Yarad/mx-anywhere-3-case/mice/mx-anywhere-3/3d/case_closed.stl

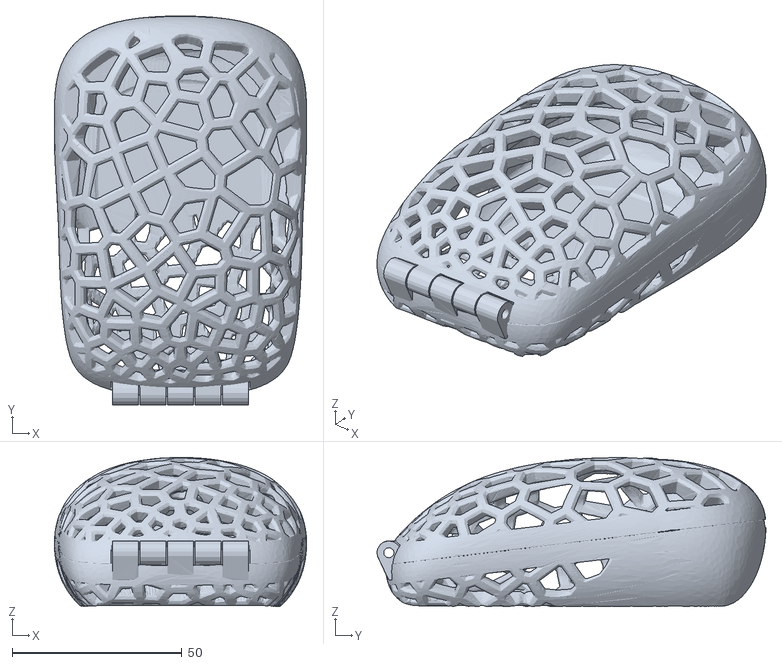
[picture p4: CAD file, 2026-11-08]
mice/mx-anywhere-3/3d/case_closed.stl
74.2 x 114.5 x 43.9
