Yarad/mx-anywhere-3-case/mice/mx-anywhere-3/3d/case_open.stl

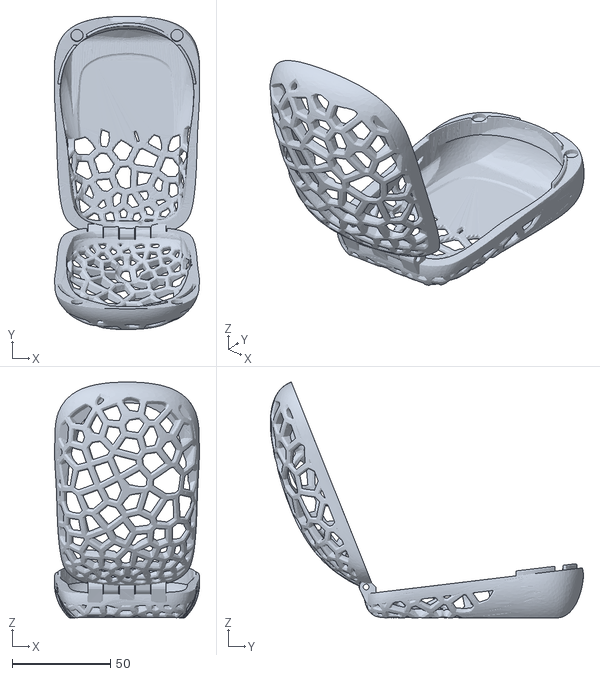
[picture p5: CAD file, 2026-11-08]
mice/mx-anywhere-3/3d/case_open.stl
74.2 x 159.8 x 120.4
