Yarad/mx-anywhere-3-case/PRINTING.ru.md

# Чехол MX Anywhere 3 — печать и сборка

[English](PRINTING.md) · **Русский**

## Файлы для печати

Готовые файлы приложены к [последнему релизу](https://github.com/Yarad/mx-anywhere-3-case/releases/latest). Чтобы собрать их самому, выполните `.venv/bin/python -m case mx-anywhere-3 build print` — они появятся в `build/mx-anywhere-3/print/` (для другой мыши — имя её папки в `mice/`):

| Файл | Что это |
| --- | --- |
| `mx_case_plate.3mf` | обе детали на одном столе, уже в положении для печати |
| `mx_case_base.stl` | основание, в положении для печати |
| `mx_case_lid.stl` | крышка, в положении для печати |

Карта демпферов — `.venv/bin/python -m case mx-anywhere-3 bumper_map`, файл `build/mx-anywhere-3/print/bumper_map.ru.png` (английская версия — `bumper_map.png`).

## Заказ

Отправлять салону печати — архив заказа из релиза (или собрать его командой `.venv/bin/python -m case mx-anywhere-3 order` в `build/mx-anywhere-3/mx-anywhere-3_case_order.zip`):

| В архиве | Что это |
| --- | --- |
| `case_base_PETG_gray.stl` | основание — **PETG серый** |
| `case_lid_PETG_white-transparent.stl` | крышка — **PETG белый прозрачный** |
| `zakaz.txt` | текст заказа: цвета, положение на столе, поддержки, настройки |
| `na_stole.png`, `cveta.png` | как детали лежат на столе и как выглядит готовый чехол |

Цвета — `[design] colors` в `case.toml` мыши (названия из `case/colors.py`), язык заказа — `[print] order_language` (`ru` или `en`). STL не хранит цвет, поэтому он в названии файла и в тексте заказа. Детали разных цветов печатаются отдельными заданиями.

## Для 3D Pixel

- **Материал:** PETG.
- **Принтер:** многоцветный 256 × 256 × 256 (Bambu); обе детали помещаются и на 220 × 220.
- **Сопло / слой:** 0.4 мм / 0.2 мм.
- **Стенки:** 3 периметра, заполнение 100 % — детали тонкие, это фактически сплошной пластик.
- **Основание:** лежит дном на столе. Поддержки **не нужны**.
- **Крышка:** лежит плоским краем (плоскостью разъёма) на столе, куполом вверх. Нужны **древовидные поддержки только от стола** (support on build plate only) — они растут внутри купола и держат рёбра сетки снизу. Снаружи крышки поддержек быть не должно.
- **Отверстия петли** имеют каплевидный верх и печатаются без поддержек.
- Ориентацию не менять: в файлах она уже правильная.

## Что купить

| Что | Сколько |
| --- | --- |
| Магниты неодимовые, диск 6 × 2 мм | 4 шт |
| Пруток / винт Ø 3 мм, длина 40 мм (винт M3 × 40, стальной пруток или спица) | 1 шт |
| Демпферы силиконовые самоклеящиеся Ø 6 × 2 мм | 12 шт |
| Демпфер Ø 4–5 × 2 мм (или кусочек того же) на носик перед колесом | 1 шт |
| Клей: цианоакрилат («супер-клей») или эпоксидка | для магнитов |

## Сборка

1. **Магниты.** В задних углах крышки и основания по гнезду Ø 6.2 мм. Сложите все 4 магнита в один столбик и пометьте маркером верхнюю сторону каждого. В основание вклейте их **помеченной стороной наружу** (к линии разъёма), в крышку — **помеченной стороной внутрь гнезда** (ко дну). Проверьте, что крышка притягивается, пока клей не схватился.
2. **Петля.** Совместите проушины крышки и основания и вставьте пруток: в проушинах основания он сидит плотно (Ø 3.0), в проушинах крышки вращается свободно (Ø 3.25). Если сел слишком туго — пройдите отверстия крышки сверлом 3.2–3.3 мм.
3. **Демпферы** — по карте ниже: 8 шт в основании, 5 шт в крышке. Каждый клеится на утолщённый узел сетки или на сплошную стенку точно под своим номером. Мышь касается чехла только через них; остальная поверхность — в 1.7 мм от мыши.

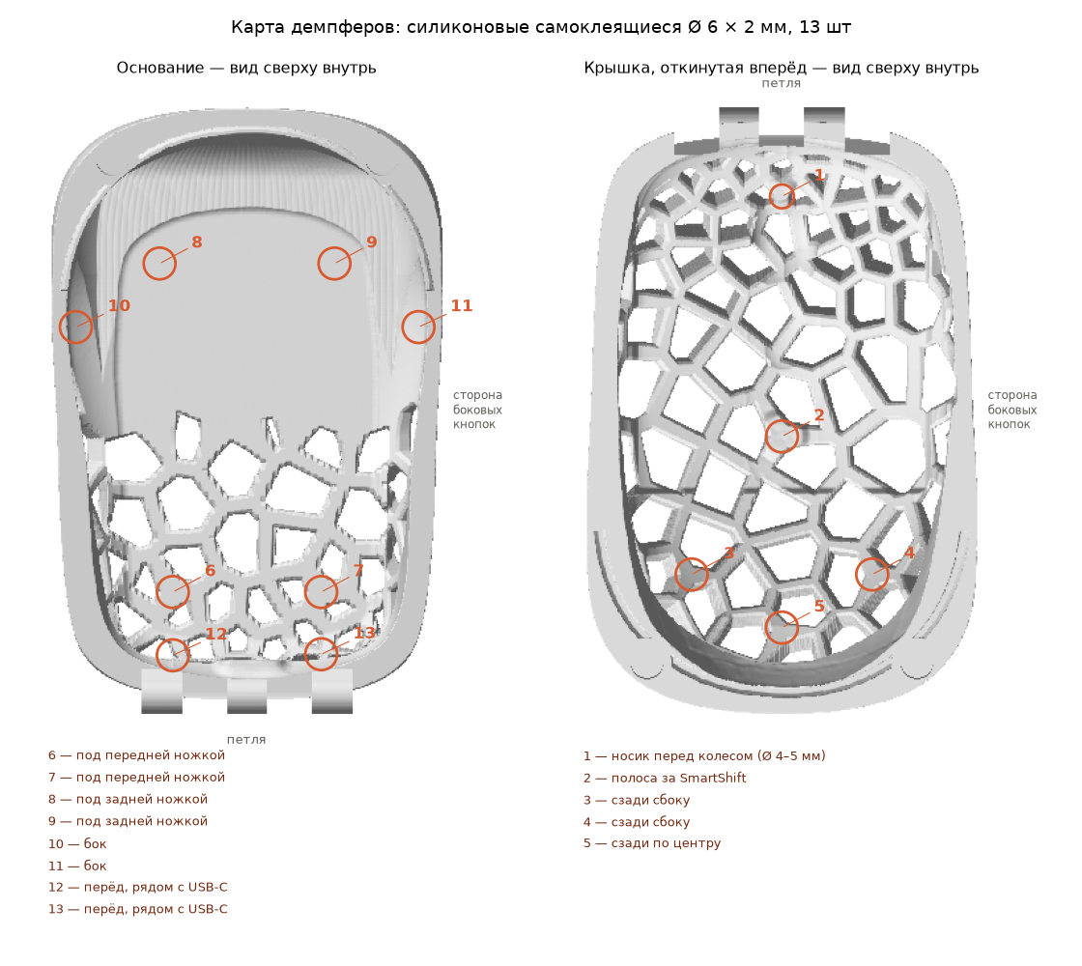
[picture p6: docs/bumper_map.ru.png]
Карта демпферов


## Параметры, если что-то не подошло

Поменяйте `case.toml` мыши (значения по умолчанию с пояснениями — в `case/defaults.toml`) и пересоберите одной командой:

- другой пруток — `[parts] rod` (отверстия крышки шире на 0.25 мм: `[tech] rod_play`);
- другие демпферы — `[parts] bumper` (зазор = высота демпфера − 0.3 мм);
- тугой или свободный бортик — `[tech] lip_clear`;
- другие магниты — `[parts] magnet`.
