Yarad/mx-anywhere-3-case/(commit log)

2026-11-01 Lattice carry case for Logitech MX Anywhere 3: first prototype
    Parametric build from the mouse scan: smooth Bezier outer form, cavity with
    gaps per zone swept along the opening motions, tilted parting plane with an
    inner lip, printed 5-knuckle hinge for a 3 mm rod, pockets for 6x2 magnets,
    contact pads, and a Voronoi lattice with wedge ribs in the "heel" layout.
    Build with: .venv/bin/python -m case.build stage2
2026-11-01 Rest the mouse on lattice nodes; shrink cells only near the hinge
    Contacts no longer get round pads: three seeds around each contact put a
    lattice node right over it, and the ribs fatten a little there to land a
    6 mm bumper. Contacts inside solid areas use the wall itself. The default
    gap is 1.7 mm so the mouse touches only the 2 mm bumpers.
    Cells shrink towards the hinge only in its last ~6 cm, and next to solid
    areas only at the very end of the transition. Solid areas are a 3 mm skin.
    Builds also write light preview GLBs that the viewer can open.
2026-11-01 Heel wraps the back of the lid; fine cells only at the hinge
    The solid heel's diagonal is steeper, so it reaches over the back edge of
    the lid: along the lid it now reads solid -> large cells -> small cells at
    the hinge. Cells no longer shrink next to solid areas; their holes close
    up instead. GLB exports are rotated to glTF's Y-up so the case lies flat
    in viewers.
2026-11-01 Print-ready build: oriented parts, plate, bumper map, checks
    `python -m case.build print` builds at 0.2 mm and writes the base (flat
    bottom on the bed) and the lid (rim on the bed, tree supports inside the
    dome only) as STL plus one 3MF plate, a bumper map and light previews.
    The approved lattice layout is pinned in case/approved_seeds.npy so it
    survives resolution and small form changes.
    Fixes found while preparing the print:
    - 45 deg print chamfer along the bottom edge of the base (was a flat
    overhang over the bed)
    - wedge ribs stop narrowing at 2 mm, inner face at least 1 mm (deep ribs
    went down to 0.3 mm)
    - lip only around the back third: along the sides the lid skirt next to
    the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
2026-11-01 Colours and the order package for the print shop
    Chosen PETG colours from 3D Pixel's palette: lid white transparent, base
    gray (PRINT_COLORS in params). `python -m case.order` zips the two STLs
    with the colour in their names, the order text, and pictures of the parts
    on the bed and of the finished case. `case.colors` renders colour schemes
    from the shop's palette for choosing.
2026-11-01 README, CC BY-NC 4.0 licence and pictures for publishing
    The mouse scan is no longer part of the repository (its licence is
    unclear); the README explains which frame a replacement scan must use.
2026-11-01 Docs in English and Russian
    English stays the main language: README.md and PRINTING.md (now
    translated), with README.ru.md and PRINTING.ru.md alongside and a language
    switch at the top of each. The case views and the bumper map are rendered
    in both languages; the order package for the print shop keeps the Russian
    pictures and order text.
2026-11-02 3D previews on GitHub and links to the release
    GitHub's own 3D viewer shows STL files up to 10 MB, so docs/3d holds the
    closed and open case as single STLs coarsened just enough to fit (0.08 mm,
    `python -m case.preview github`); no mouse in them, the scan stays private.
    The READMEs link to them and to the latest release, where the print files
    live, so the case can be printed without Python or the scan.
    Each part now keeps only its one real body: marching cubes left about 40
    sub-voxel crumbs in the base lattice that slicers would flag.
    [case_closed.stl, case_open.stl]
2026-11-02 A case for any mouse: per-mouse config, automatic fit and the mouse-case skill
    Everything that was fitted to the MX Anywhere 3 by hand now lives in
    mice/<mouse>/: case.toml holds the mouse (mesh, button zones, contacts) and
    the design choices over case/defaults.toml, derived.toml the geometry fitted
    to the mouse, seeds.npy the approved lattice. The MX3 config reproduces the
    previous print files to numerical noise (same volumes, same 209 cells).
    New mice come in through `python -m case <mouse> new`: a scan is turned into
    the case frame automatically (flat bottom down, front away from the hump,
    yaw by mirror symmetry; units guessed), or a stand-in is built from length,
    width and height. Butto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
    [case_closed.stl, case_open.stl]
2026-11-08 Finger notch in the base, like a MacBook Pro's
    The lid's back edge sat flush on the base, with nothing for a finger to catch.
    The base's top edge at the magnet end is now chamfered at 45 degrees under
    the lid: 2.5 mm leg, 20 mm point to point, the ends narrowing to a point over
    3 mm. The lid is unchanged; the base differs from v1.0 only at the notch.
    It is a design choice for every mouse ([design] notch, notch_size), cut as an
    exact mesh like the magnet pockets. The build reports the room it leaves to
    the lid's groove and the magnets; `options notch` draws it with and without.
    [case_closed.stl, case_open.stl]
